hoony9845/msx-vdp-cartridge/hardware/fab/msx_v9990_cart_hole_check_print96.pdf

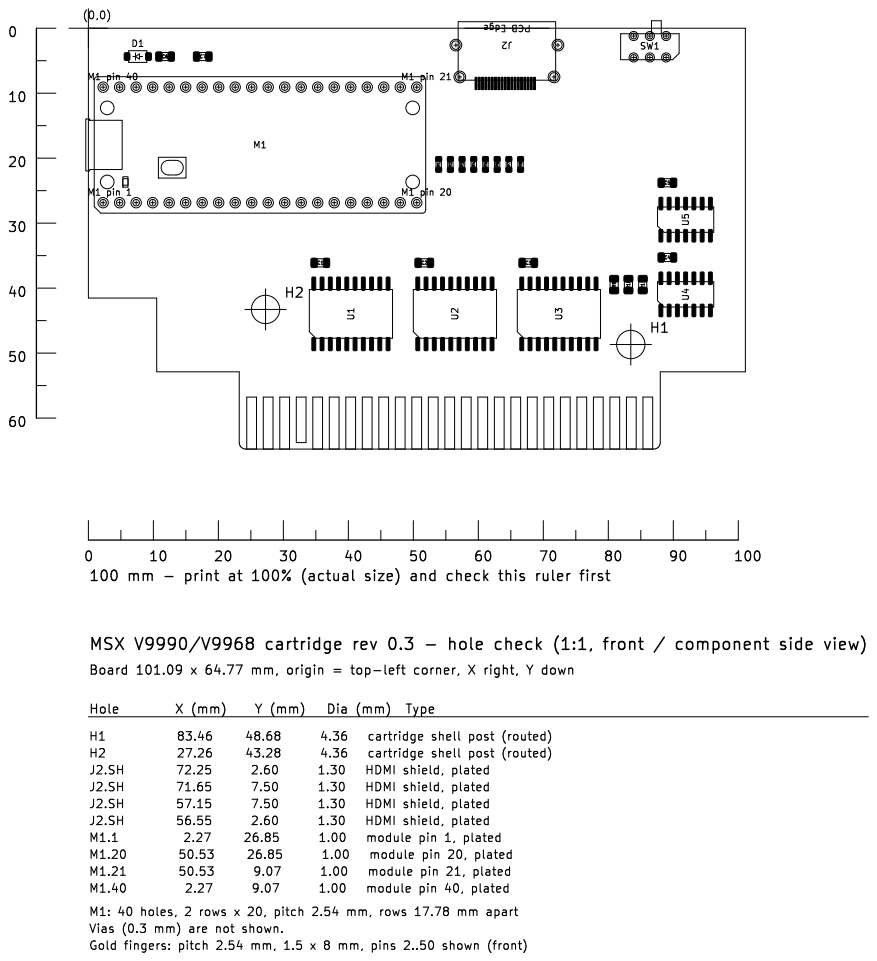
[picture p1: page 1]

Vias (0.3 mm) are not shown.
