hoony9845/msx-vdp-cartridge/hardware/fab_core2350b/msx_v9990_cart_core2350b_hole_check.pdf

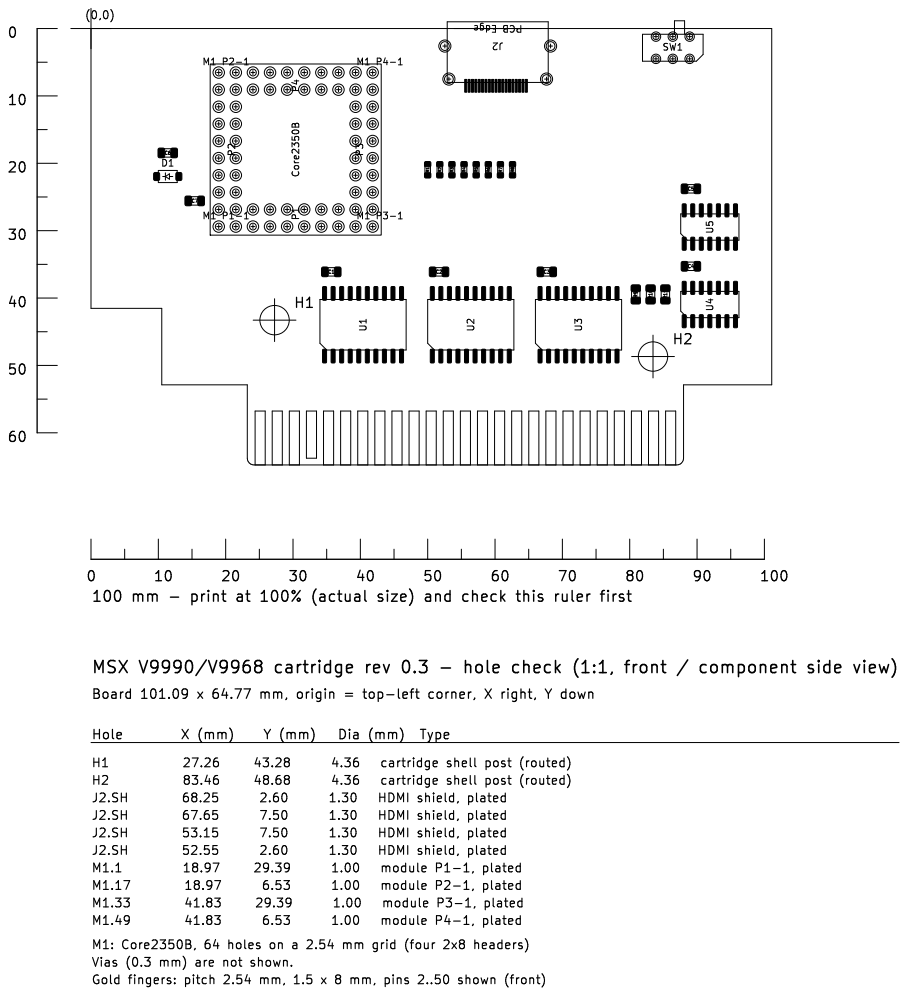
[picture p2: page 1]

Vias (0.3 mm) are not shown.
