hoony9845/msx-vdp-cartridge/hardware/fab_core2350b/msx_v9990_cart_core2350b_schematic.pdf

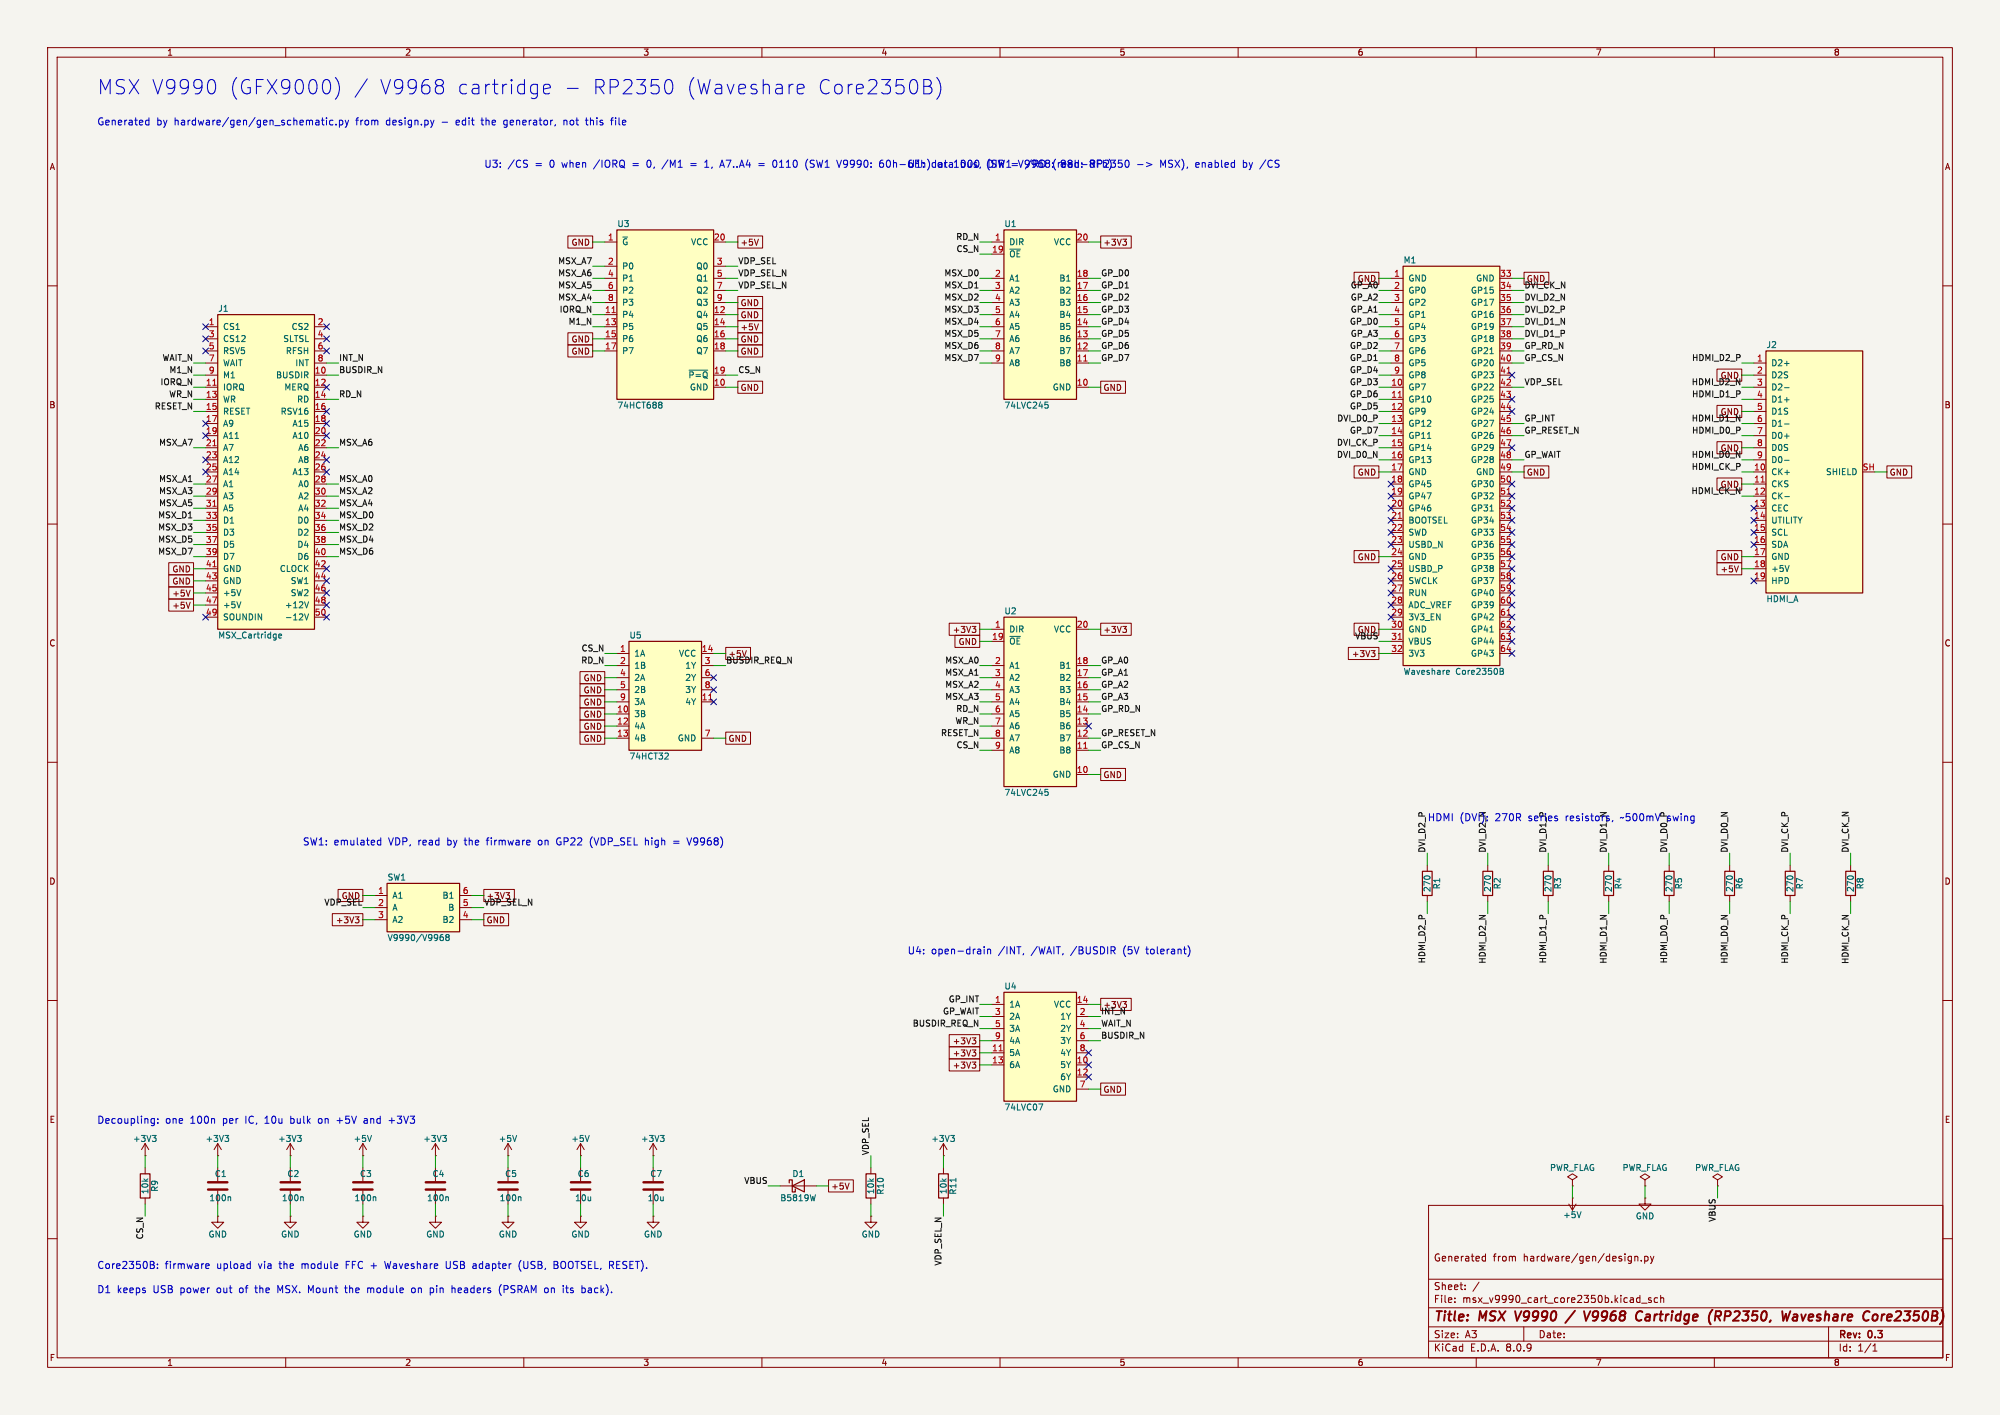
[picture p4: page 1]

GND 1 GP7 10 GP10 11 GP9 12 GP12 13 GP11 14 GP14 15 GP13 16 GND 17 GP45 18 GP47 19 GP0 2 GP46 20 BOOTSEL 21 SWD 22 USBD_N 23 GND 24 USBD_P 25 SWCLK 26 RUN 27 ADC_VREF 28
+3V3 GND GND GND GND
3V3_EN 29 GP2 3 GND 30 VBUS 31
