hoony9845/msx-vdp-cartridge/hardware/fab/msx_v9990_cart_hole_check.pdf

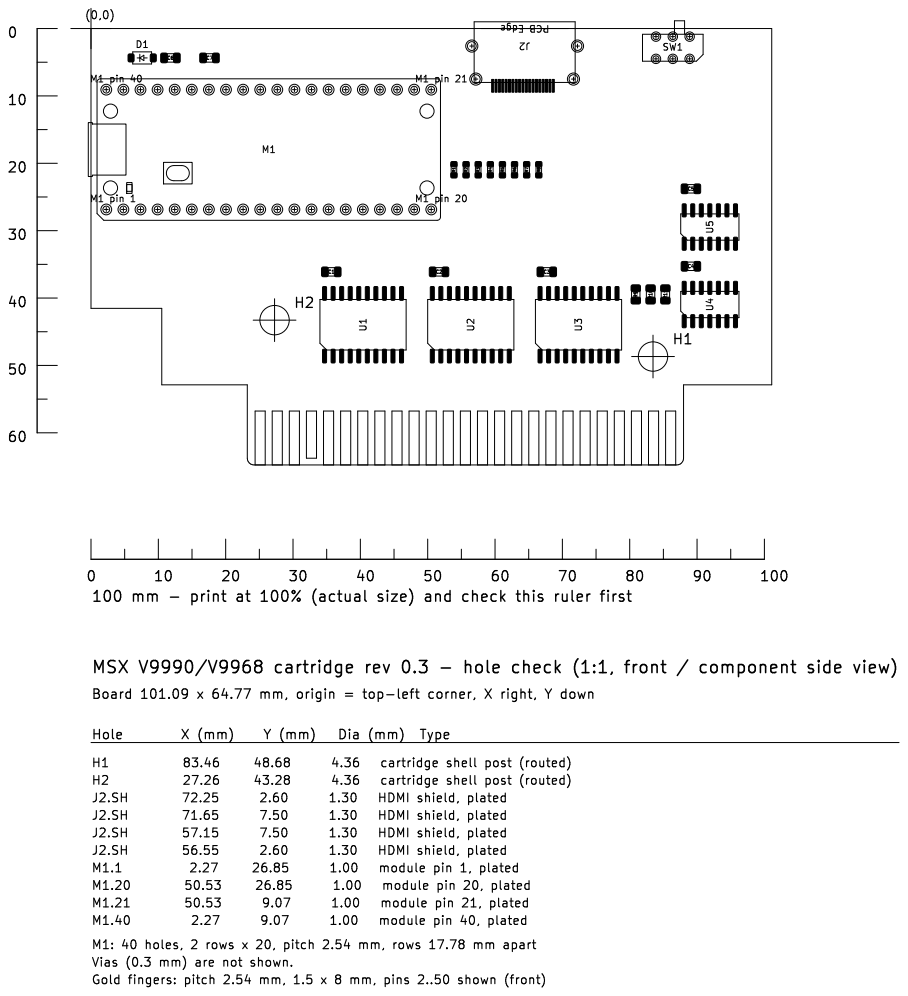
[picture p5: page 1]
