hoony9845/msx-vdp-cartridge/hardware/fab/msx_v9990_cart_schematic.pdf

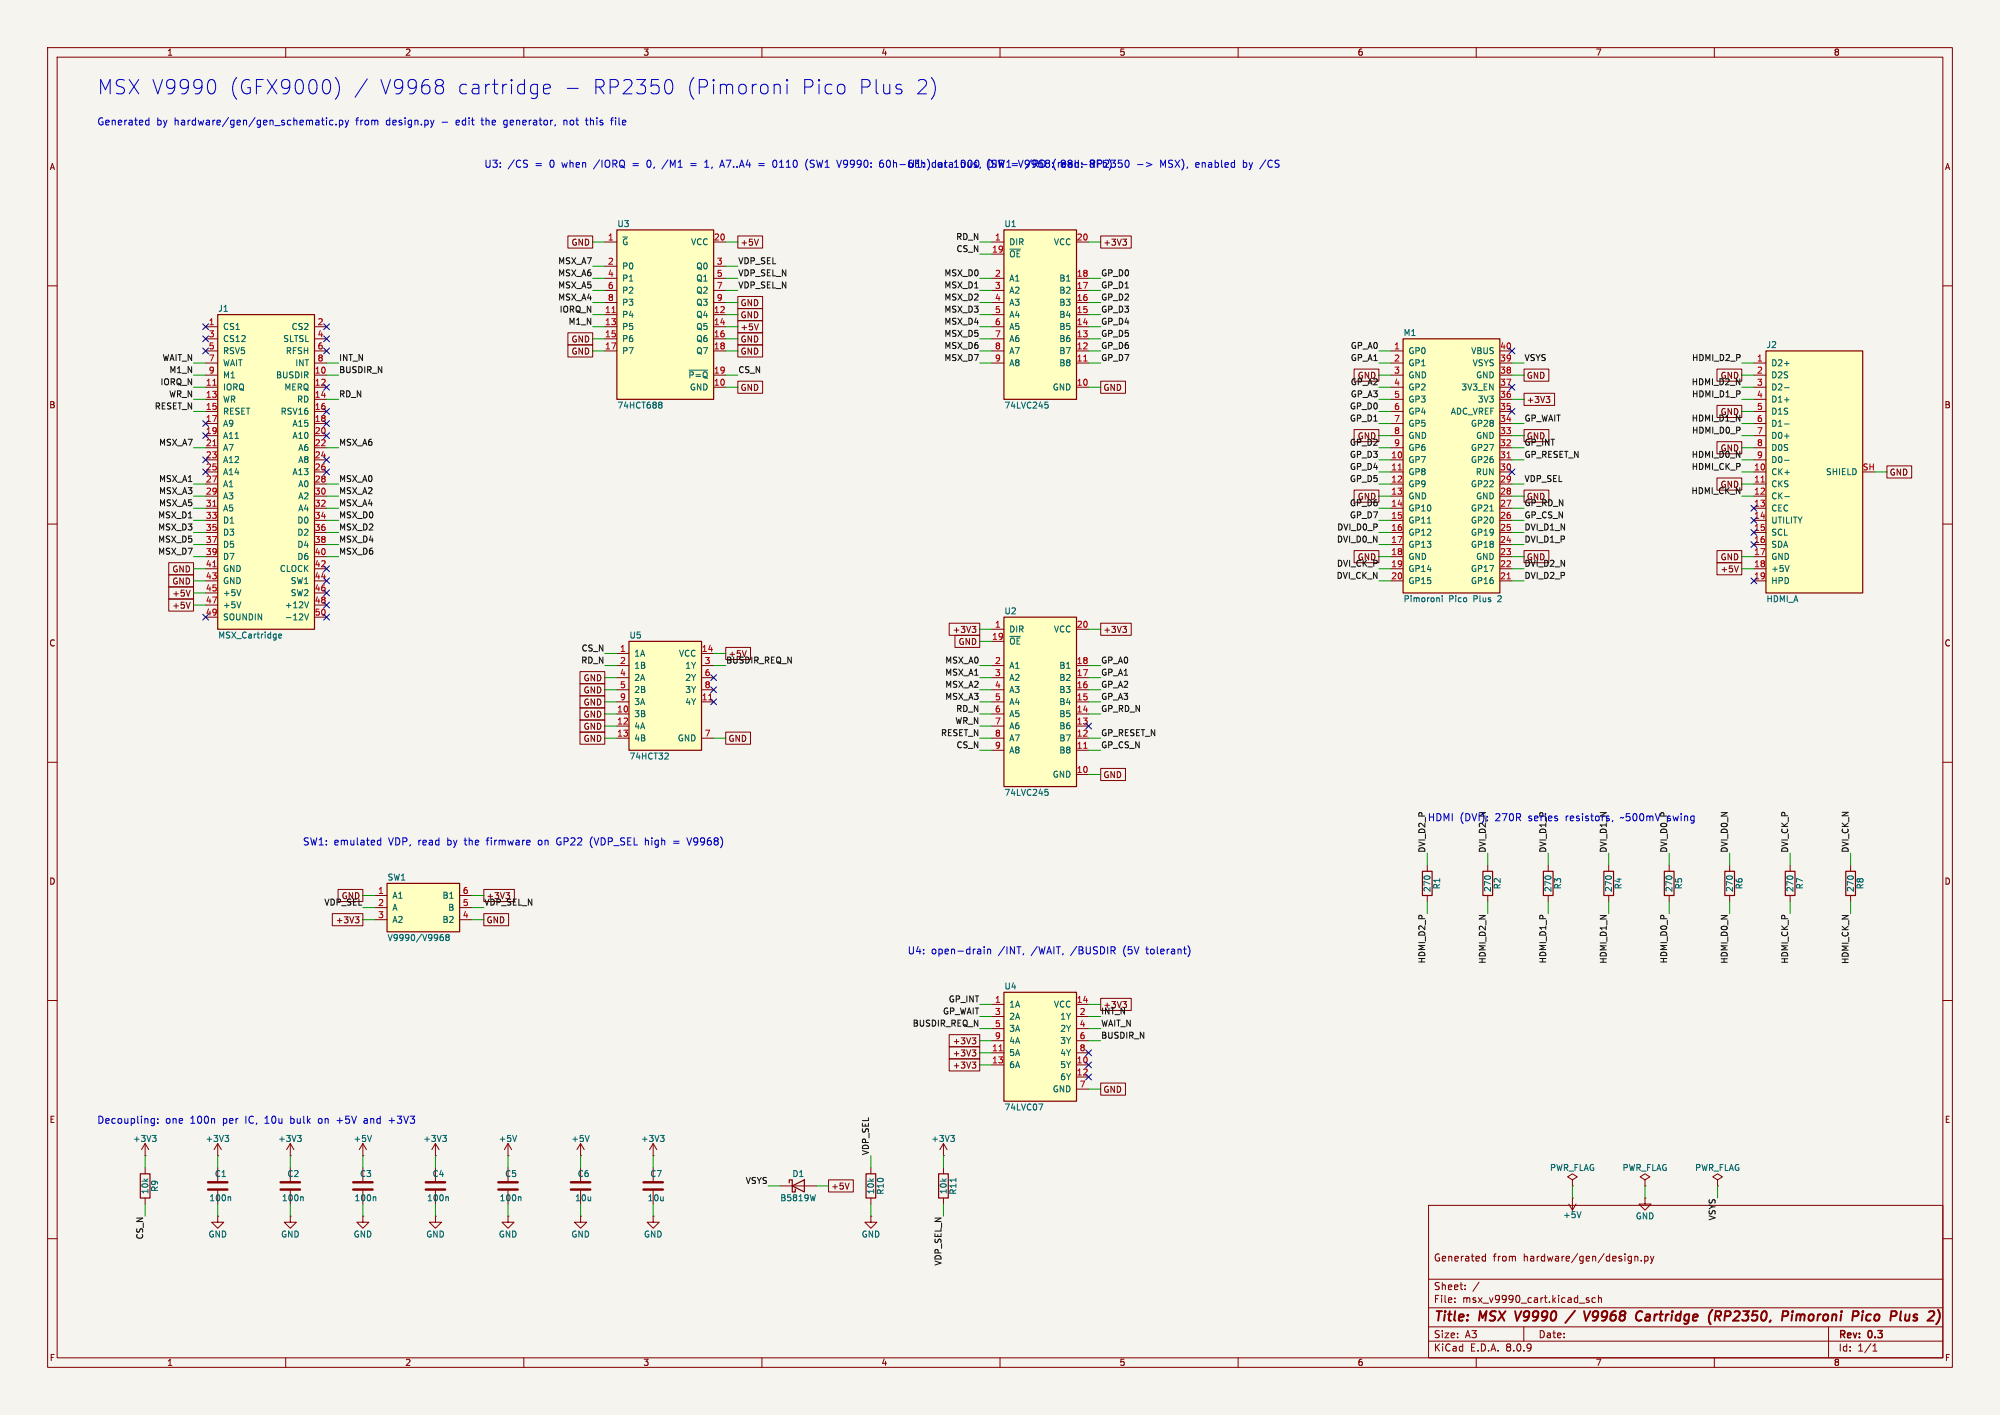
[picture p6: page 1]
