hoony9845/msx-vdp-cartridge/hardware/msx_v9990_cart/msx_v9990_cart.kicad_pcb

## KiCad design hardware/msx_v9990_cart/msx_v9990_cart.kicad_pcb (2026-10-25)

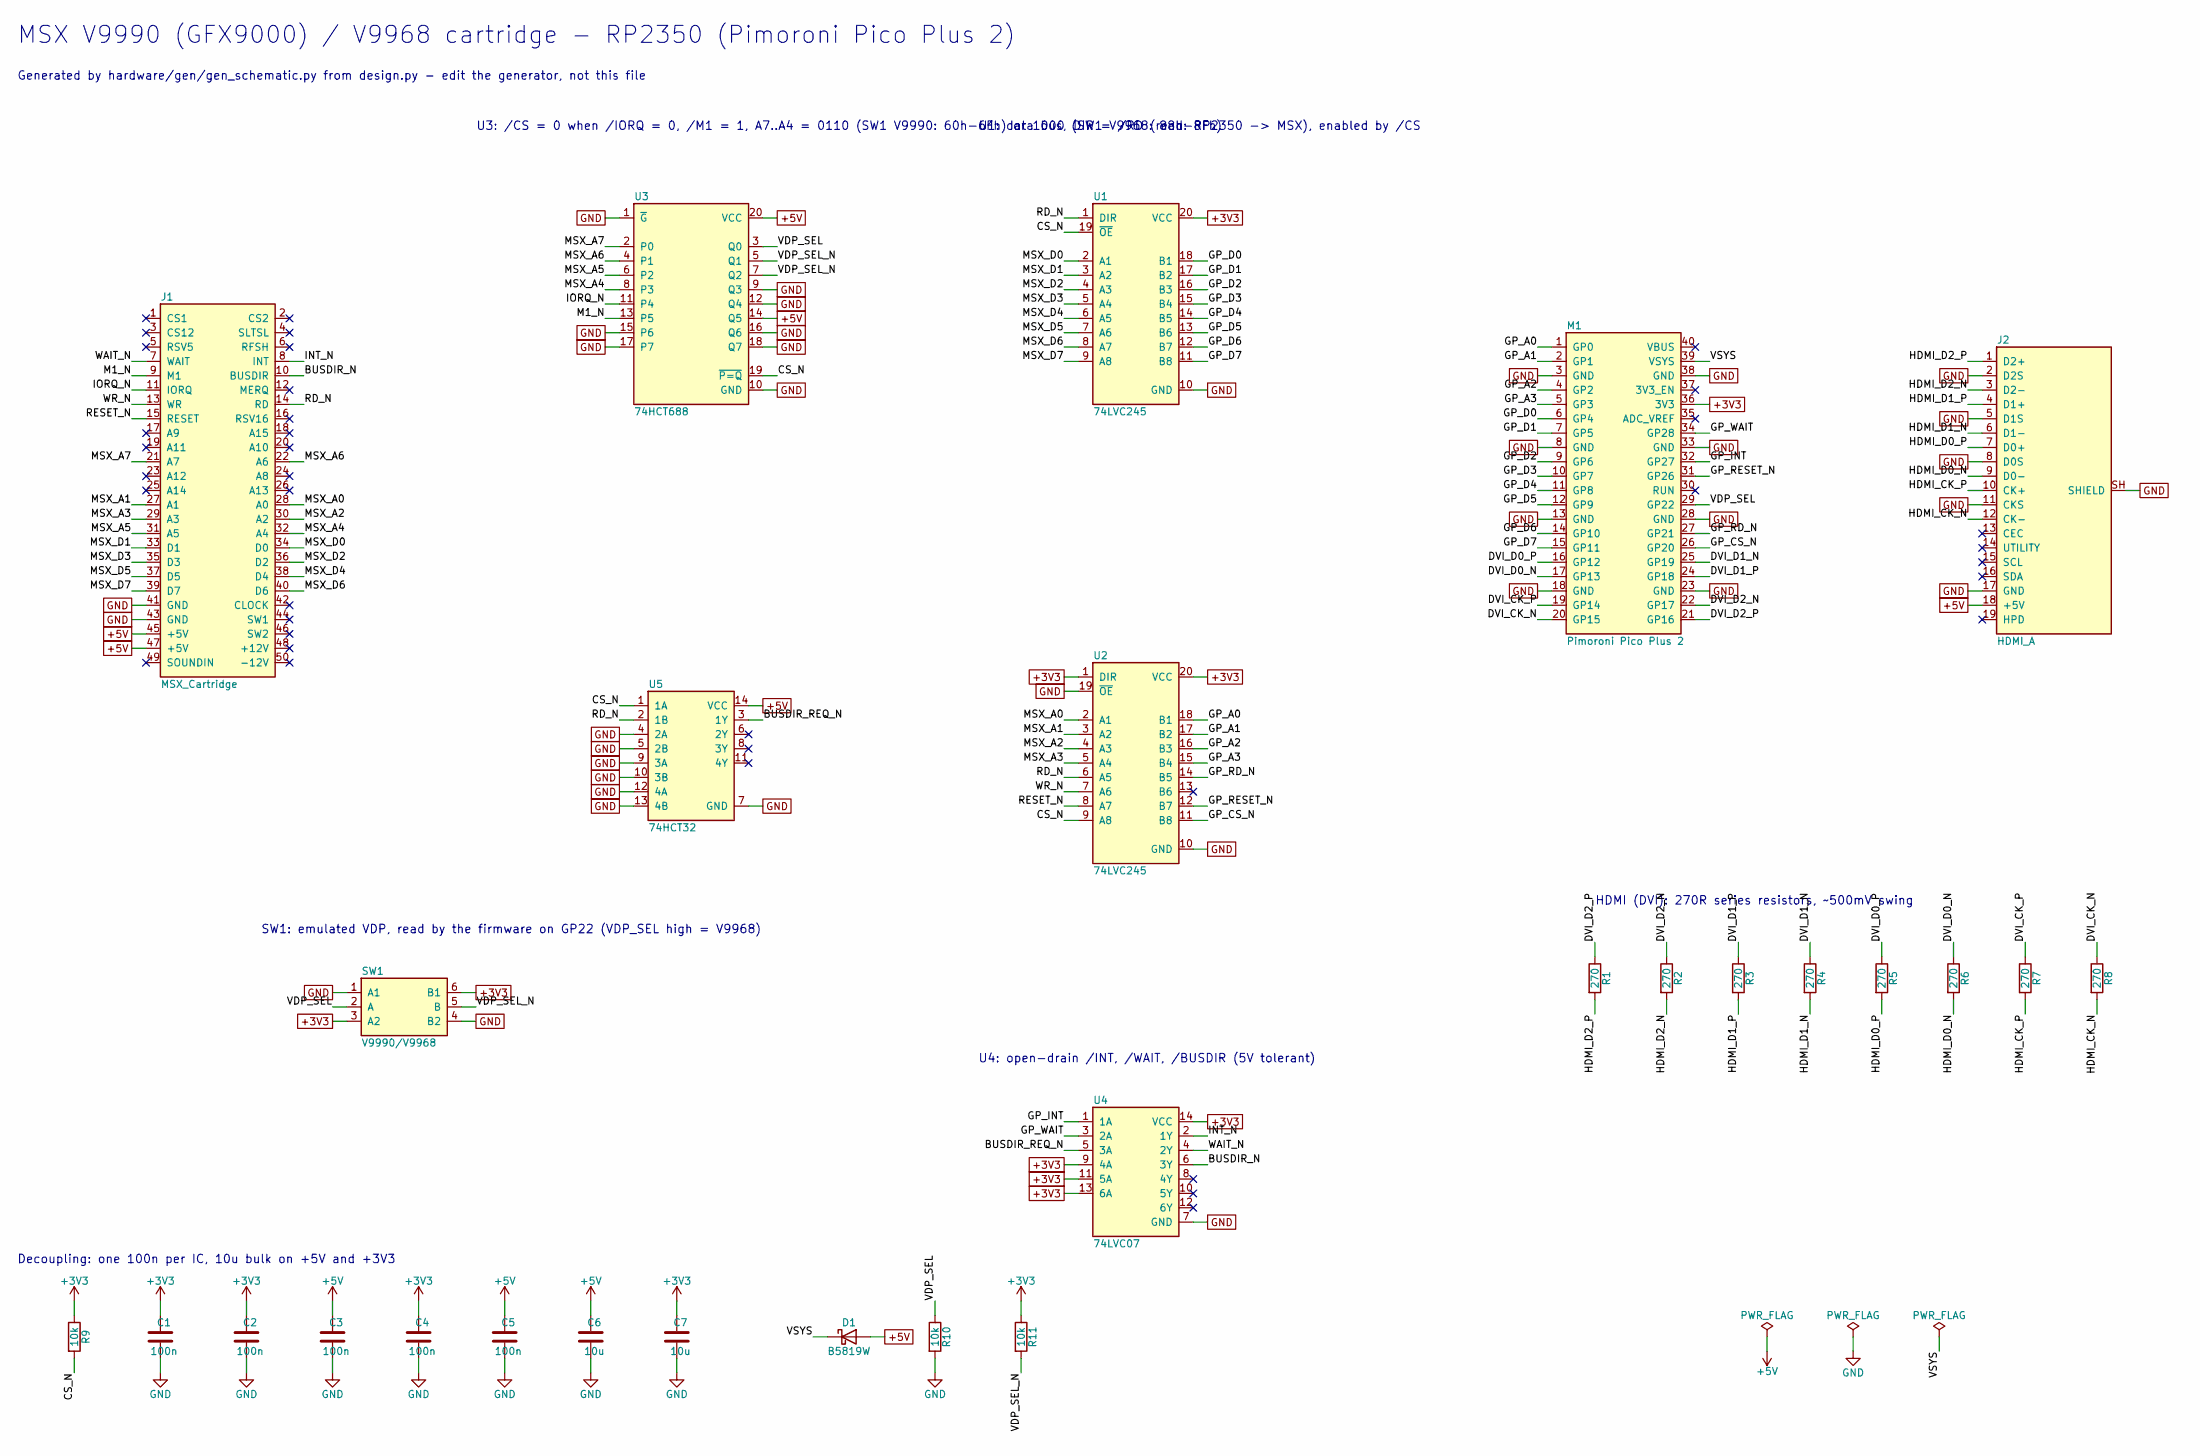
[picture p7: schematic msx_v9990_cart.kicad_sch, MSX V9990 / V9968 Cartridge (RP2350, Pimoroni Pico Plus 2)]

Parts:
C1, C2, C3, C4, C5: 100n; C_0805_2012Metric; MPN CL21B104KBCNNNC
C6, C7: 10u; C_0805_2012Metric; MPN CL21A106KAYNNNE
D1: B5819W; D_SOD-123; MPN B5819W
J1: MSX_Cartridge; MSX_Cartridge_Edge
J2: HDMI_A; HDMI_A_Amphenol_10029449-x01xLF_Horizontal; MPN 10029449-001RLF
M1: Pimoroni Pico Plus 2; RaspberryPi_Pico_Common_THT
R1, R2, R3, R4, R5, R6, R7, R8: 270; R_0603_1608Metric; MPN 0603WAF2700T5E
R9, R10, R11: 10k; R_0805_2012Metric; MPN 0805W8F1002T5E
SW1: V9990/V9968; SW_CK_JS202011AQN_DPDT_Angled; MPN JS202011AQN
U1, U2: 74LVC245; SOIC-20W_7.5x12.8mm_P1.27mm; MPN SN74LVC245ADWR
U3: 74HCT688; SOIC-20W_7.5x12.8mm_P1.27mm; MPN 74HCT688D
U4: 74LVC07; SOIC-14_3.9x8.7mm_P1.27mm; MPN SN74LVC07AD
U5: 74HCT32; SOIC-14_3.9x8.7mm_P1.27mm; MPN 74HCT32D

Connections:
+3V3: C1.1, C2.1, C4.1, C7.1, M1.36 (3V3), R9.1, R11.1, SW1.3 (A2), SW1.6 (B1), U1.20 (VCC), U2.1 (DIR), U2.20 (VCC), U4.9 (4A), U4.11 (5A), U4.13 (6A), U4.14 (VCC)
+5V: C3.1, C5.1, C6.1, D1.2 (A), J1.45 (+5V), J1.47 (+5V), J2.18 (+5V), U3.14 (Q5), U3.20 (VCC), U5.14 (VCC)
/BUSDIR_N: J1.10 (BUSDIR), U4.6 (3Y)
/BUSDIR_REQ_N: U4.5 (3A), U5.3 (1Y)
/CS_N: R9.2, U1.19 (~OE), U2.9 (A8), U3.19 (~P=Q), U5.1 (1A)
/DVI_CK_N: M1.20 (GP15), R8.1
/DVI_CK_P: M1.19 (GP14), R7.1
/DVI_D0_N: M1.17 (GP13), R6.1
/DVI_D0_P: M1.16 (GP12), R5.1
/DVI_D1_N: M1.25 (GP19), R4.1
/DVI_D1_P: M1.24 (GP18), R3.1
/DVI_D2_N: M1.22 (GP17), R2.1
/DVI_D2_P: M1.21 (GP16), R1.1
/GP_A0: M1.1 (GP0), U2.18 (B1)
/GP_A1: M1.2 (GP1), U2.17 (B2)
/GP_A2: M1.4 (GP2), U2.16 (B3)
/GP_A3: M1.5 (GP3), U2.15 (B4)
/GP_CS_N: M1.26 (GP20), U2.11 (B8)
/GP_D0: M1.6 (GP4), U1.18 (B1)
/GP_D1: M1.7 (GP5), U1.17 (B2)
/GP_D2: M1.9 (GP6), U1.16 (B3)
/GP_D3: M1.10 (GP7), U1.15 (B4)
/GP_D4: M1.11 (GP8), U1.14 (B5)
/GP_D5: M1.12 (GP9), U1.13 (B6)
/GP_D6: M1.14 (GP10), U1.12 (B7)
/GP_D7: M1.15 (GP11), U1.11 (B8)
/GP_INT: M1.32 (GP27), U4.1 (1A)
/GP_RD_N: M1.27 (GP21), U2.14 (B5)
/GP_RESET_N: M1.31 (GP26), U2.12 (B7)
/GP_WAIT: M1.34 (GP28), U4.3 (2A)
/HDMI_CK_N: J2.12 (CK-), R8.2
/HDMI_CK_P: J2.10 (CK+), R7.2
/HDMI_D0_N: J2.9 (D0-), R6.2
/HDMI_D0_P: J2.7 (D0+), R5.2
/HDMI_D1_N: J2.6 (D1-), R4.2
/HDMI_D1_P: J2.4 (D1+), R3.2
/HDMI_D2_N: J2.3 (D2-), R2.2
/HDMI_D2_P: J2.1 (D2+), R1.2
/INT_N: J1.8 (INT), U4.2 (1Y)
/IORQ_N: J1.11 (IORQ), U3.11 (P4)
/M1_N: J1.9 (M1), U3.13 (P5)
/MSX_A0: J1.28 (A0), U2.2 (A1)
/MSX_A1: J1.27 (A1), U2.3 (A2)
/MSX_A2: J1.30 (A2), U2.4 (A3)
/MSX_A3: J1.29 (A3), U2.5 (A4)
/MSX_A4: J1.32 (A4), U3.8 (P3)
/MSX_A5: J1.31 (A5), U3.6 (P2)
/MSX_A6: J1.22 (A6), U3.4 (P1)
/MSX_A7: J1.21 (A7), U3.2 (P0)
/MSX_D0: J1.34 (D0), U1.2 (A1)
/MSX_D1: J1.33 (D1), U1.3 (A2)
/MSX_D2: J1.36 (D2), U1.4 (A3)
/MSX_D3: J1.35 (D3), U1.5 (A4)
/MSX_D4: J1.38 (D4), U1.6 (A5)
/MSX_D5: J1.37 (D5), U1.7 (A6)
/MSX_D6: J1.40 (D6), U1.8 (A7)
/MSX_D7: J1.39 (D7), U1.9 (A8)
/RD_N: J1.14 (RD), U1.1 (DIR), U2.6 (A5), U5.2 (1B)
/RESET_N: J1.15 (RESET), U2.8 (A7)
/VDP_SEL: M1.29 (GP22), R10.1, SW1.2 (A), U3.3 (Q0)
/VDP_SEL_N: R11.2, SW1.5 (B), U3.5 (Q1), U3.7 (Q2)
/VSYS: D1.1 (K), M1.39 (VSYS)
/WAIT_N: J1.7 (WAIT), U4.4 (2Y)
/WR_N: J1.13 (WR), U2.7 (A6)
GND: C1.2, C2.2, C3.2, C4.2, C5.2, C6.2, C7.2, J1.41 (GND), J1.43 (GND), J2.2 (D2S), J2.5 (D1S), J2.8 (D0S), J2.11 (CKS), J2.17 (GND), J2.SH (SHIELD), M1.3 (GND), M1.8 (GND), M1.13 (GND), M1.18 (GND), M1.23 (GND), M1.28 (GND), M1.33 (GND), M1.38 (GND), R10.2, SW1.1 (A1), SW1.4 (B2), U1.10 (GND), U2.10 (GND), U2.19 (~OE), U3.1 (~G), U3.9 (Q3), U3.10 (GND), U3.12 (Q4), U3.15 (P6), U3.16 (Q6), U3.17 (P7), U3.18 (Q7), U4.7 (GND), U5.4 (2A), U5.5 (2B), U5.7 (GND), U5.9 (3A), U5.10 (3B), U5.12 (4A), U5.13 (4B)

Notes on the sheet:
MSX V9990 (GFX9000) / V9968 cartridge - RP2350 (Pimoroni Pico Plus 2)
Generated by hardware/gen/gen_schematic.py from design.py - edit the generator, not this file
U3: /CS = 0 when /IORQ = 0, /M1 = 1, A7..A4 = 0110 (SW1 V9990: 60h-6Fh) or 1000 (SW1 V9968: 88h-8Fh)
SW1: emulated VDP, read by the firmware on GP22 (VDP_SEL high = V9968)
U1: data bus, DIR = /RD (read: RP2350 -> MSX), enabled by /CS
U4: open-drain /INT, /WAIT, /BUSDIR (5V tolerant)
HDMI (DVI): 270R series resistors, ~500mV swing
Decoupling: one 100n per IC, 10u bulk on +5V and +3V3

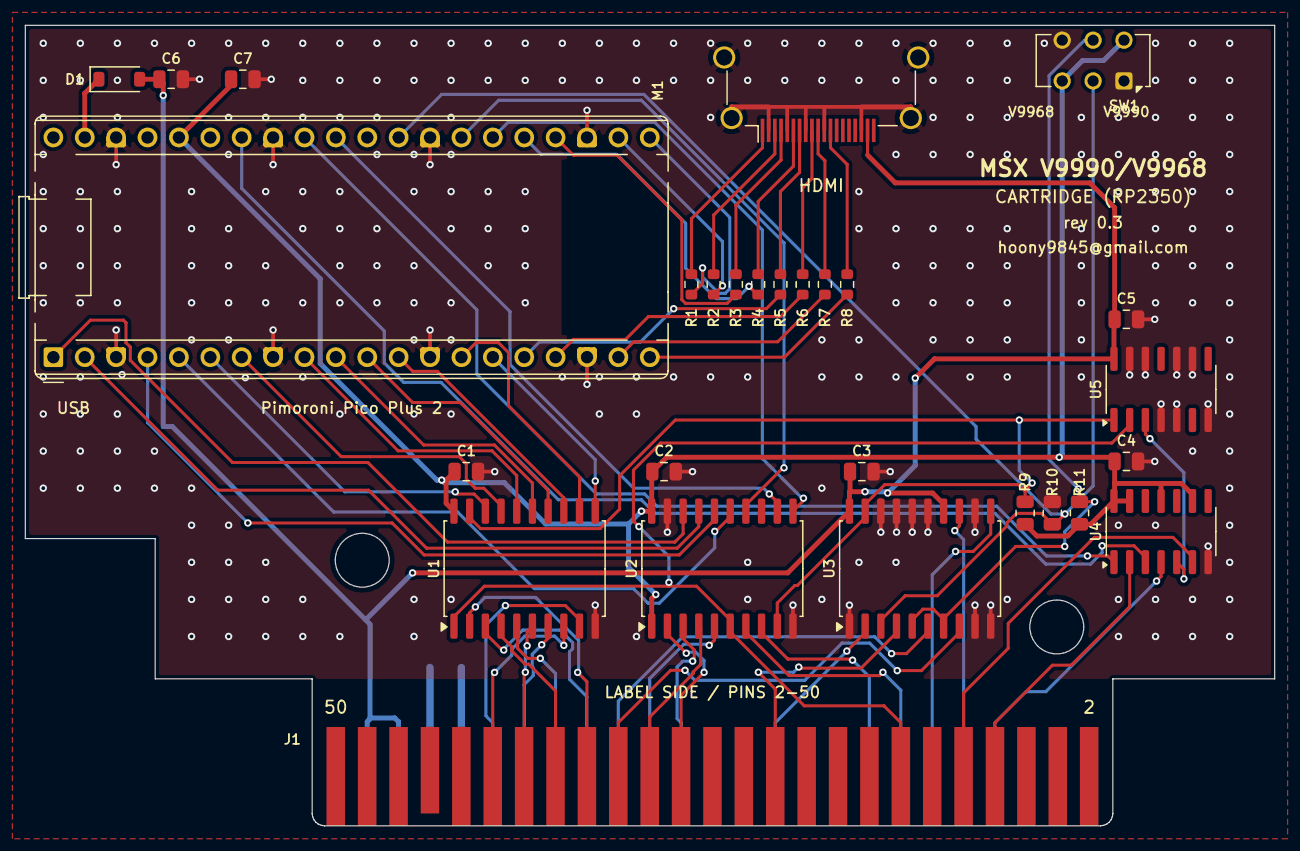
[picture p8: board msx_v9990_cart.kicad_pcb from above]

Board: 2 copper layers, 101.1 x 64.8 mm, 28 parts (0 on the bottom side), 65 nets.
