hoony9845/msx-vdp-cartridge/(commit log)

2026-10-21 Initial commit: RP2350-based V9990 (GFX9000 compatible) MSX cartridge
    - core/: portable V9990 core (ports, registers, palette, bitmap renderer,
    command engine STOP/LMMC/LMMV/PSET), shared by host and firmware
    - host/: PC unit tests and a render demo
    - firmware/: pico-sdk project for the Pimoroni Pico Plus 2 (PIO + DMA MSX
    bus interface, HSTX DVI 640x480 output, PSRAM VRAM, dual-core)
    - hardware/: generated KiCad 8 cartridge PCB (schematic, layout, Freerouting
    autoroute, GND pours) with JLCPCB Gerbers, BOM, CPL and a 1:1 hole check PDF
    - docs/: wiring and pin assignment
    [msx_v9990_cart-B_Cu.gbl, msx_v9990_cart-B_Mask.gbs, msx_v9990_cart-B_Paste.gbp, msx_v9990_cart-B_Silkscreen.gbo, msx_v9990_cart-Edge_Cuts.gm1, msx_v9990_cart-F_Cu.gtl, msx_v9990_cart-F_Mask.gts, msx_v9990_cart-F_Paste.gtp]
2026-10-21 Add Waveshare Core2350B cartridge variant; silkscreen fixes
    Hardware
    - Generators take MSX_VARIANT=picoplus2|core2350b; the Core2350B board
    (msx_v9990_cart_core2350b/, fab_core2350b/) shares outline, edge
    connector, bus logic and HDMI with the Pico Plus 2 board
    - Core2350B: generated 64-pin footprint (four 2x8 headers, pin map from the
    Waveshare schematic), module on pin headers (PSRAM on its back), MSX +5V
    via D1 into VBUS; USB/BOOTSEL/RESET come from the Waveshare FFC adapter
    - Fixed 0.3mm escapes for the inner-ring 3V3/GND pins, GND fan-out rules
    for the module, variant-aware BOM and hole-check PDF
    - Both boards: shortened tongue (fingers to the edge), moved H1/H2, email
    on th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
    [msx_v9990_cart-B_Cu.gbl, msx_v9990_cart-B_Mask.gbs, msx_v9990_cart-B_Paste.gbp, msx_v9990_cart-B_Silkscreen.gbo, msx_v9990_cart-Edge_Cuts.gm1, msx_v9990_cart-F_Cu.gtl, msx_v9990_cart-F_Mask.gts, msx_v9990_cart-F_Paste.gtp]
2026-10-23 Core: P1/P2 pattern modes, sprites, LMMM, mode decoding per manual
    - P1: two layers with per-layer palettes, front/back split (R#27), scroll
    - P2: 1024x512 image plane, even/odd PGT byte palettes
    - P1/P2 sprites: 125 entries, 16 per line (hidden ones count), front/back
    priority, lower number wins, X wrap above 1008, SPD disable
    - Vertical scroll split (writing SCAY/SCBY low restarts the layer at the
    current line), per-frame latch of the high bytes, R512/R256 roll
    - Display mode decoding from the manual's table (B2/B4 via MCS, B5/B6 via
    HSCN/C25M); interlace height only with IL+EO
    - VRAM pointers update on R#2/R#5 only; register write masks
    - LMMM (bitmap coordinates) in the command eng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
2026-10-23 Add openMSX comparison harness and trace recorder
    - host/replay: replays a V9990 port trace through the core, writes shots
    - tools/compare: scenario generator, headless openMSX 16.0 runner (GFX9000),
    dot-accurate comparison (calibration shots locate the display area and
    every dot column), report with side-by-side diff images
    - record.tcl/record.sh: record real software's V9990 port accesses
    (watchpoints) plus periodic screenshots; compare_trace.sh replays and
    compares; selftest_record runs a Z80 program end to end
    - All scenarios (P1 layers/scroll, P2, sprites, BD16, BP4 B3, LMMV, LMMM)
    match openMSX 16.0 exactly
2026-10-23 CMMC/CMMM, positional FC/BC colours; Chase H.Q. regression test
    Core
    - CMMC and CMMM (1 bit per dot, MSB first, continuous across rows;
    FC for 1, BC for 0)
    - FC/BC/WM follow VRAM bit positions (bits 0-7 = VRAM0/even byte,
    8-15 = VRAM1/odd byte, 2/4bpp use the dot's bits) for LMMV, PSET, CMMx
    - Resolved the remaining VERIFY notes against the manual (NX/NY = 0,
    LMMC data order, write mask lanes, P2 VRAM layout)
    Compare tools
    - record.tcl keeps only the low byte of 16-bit I/O addresses (OUT (C),A)
    - shot_window.py + compare.py --window: best of -4..+2 frames around each
    recorded shot, tearing detection (every line matches some frame)
    - compare_trace.sh: V9990_SKIP_BEFORE skips power-on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
    [v9990.h, v9990_cmd.c, v9990_regs.h]
2026-10-23 Verify Another World (turbo R) and VRAM-level comparison
    - Another World (Edd Biddulph, turbo R + V9990 + OPL4): 113/113 shots of
    the 4-minute intro match openMSX 16.0 (B2 384x240 BP4, LMMV XOR polygons)
    - setup_machines.sh / make_cbios_turbor.py: C-BIOS based turbo R test
    machine (version byte 3, CHGCPU/GETCPU via S1990, R800, E6 timer, PCM)
    and a MoonSound without the Yamaha wave ROM - no system ROMs needed
    - B2 calibration (384x240, MCS) and per-line vertical calibration:
    openMSX hides the first line of the 240-line modes
    - VRAM dumps at every shot (record.tcl V9990_DUMP_VRAM, replay
    REPLAY_DUMP_VRAM) and compare_vram.py: Chase H.Q. VRAM equals openMSX at
    69 of 73 shots includ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
2026-10-25 Add V9968 + geo3d v2.0 emulation, selectable in firmware
    - core/v9968*.c: V9968 (V9958 superset): ports, registers, Port#4
    interrupts/lock, 256KB VRAM, all screen modes incl. YJK/YAE and EPAL,
    sprite modes 1-3 (SP3 scaling, reversal, palette sets, transparency),
    every command incl. LRMM/LFMC/LFMM, following HRA!'s RTL
    - core/geo3d.c: geo3d v2.0, a port of the bit-exact Python reference
    model; commands are fed to the V9968 command engine when CE = 0
    - firmware: chip chosen at boot (CMake MSX_VDP_DEFAULT, USB serial
    'chip v9990|v9968' saved in flash); V9968 at nibble 8-F of the decoded
    ports, VRAM in SRAM, just-in-time line rendering for raster effects
    - verification: geo3d logs id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
    [bus.c, bus.h, dvi_out.c, dvi_out.h, gen_cmds.py, geo3d.c, geo3d.h]
2026-10-25 PCB rev 0.2: SW1 selects the V9990 or the V9968 cartridge
    - SW1 (C&K JS202011AQN, DPDT, right angle, top edge): sets the 74HCT688
    compare value A7-A4 to 0110 (V9990, 60h-6Fh) or 1000 (V9968 + geo3d,
    88h-8Fh) and drives GP22 (VDP_SEL); R10/R11 hold the inputs while the
    slider moves
    - GP22 reads SW1 instead of /WR (U2 still buffers /WR, output open)
    - firmware: the chip follows SW1 at boot (MSX_VDP_SWITCH, default ON);
    rev 0.1 boards build with -DMSX_VDP_SWITCH=OFF (flash / USB serial)
    - both variants regenerated: ERC 0, DRC 0, 0 unconnected
    [msx_v9990_cart-B_Cu.gbl, msx_v9990_cart-B_Mask.gbs, msx_v9990_cart-B_Paste.gbp, msx_v9990_cart-B_Silkscreen.gbo, msx_v9990_cart-Edge_Cuts.gm1, msx_v9990_cart-F_Cu.gtl, msx_v9990_cart-F_Mask.gts, msx_v9990_cart-F_Paste.gtp]
2026-10-25 V9968 renderer: YJK delay, YAE transparency, sprites ignore R#27
    - YJK/YAE: the picture and the sprites come out 4 dots late (J/K need a
    whole group), the first 4 dots show the border, as in openMSX
    - YAE: palette colour 0 is transparent (border unless TP)
    - sprites are not shifted by R#27 (vdp_sprite_makeup_pixel gets the
    unscrolled position); only hidden in the border R#27 opens
    - compare: YJK sprite colour scenes; trace2cmds.py and REPLAY_GEO3D_CMDS
    run a scenario's commands through HRA!'s RTL: LRMM, LFMM and the geo3d
    textured scene give the same 256KB of VRAM as the core, so their
    remaining differences to the openMSX fork are on the fork's side
    - rtl/bisect.py: first command w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
2026-10-25 V9968 LMCM: the end check before the first read; fix the RTL replay
    - LMCM ends without reading when it starts past the edge of its last line
    (vdp_command.v checks before the first read)
    - v9968_cmd_replay: a command waiting for CPU data takes the next
    command's R#44 at once, as the RTL running in parallel does (and the
    firmware, whose engine always runs); a stale TR no longer stops other
    commands. The open RTL differences (sets 2140, 2240, 2241, 2250, 2281)
    were these two replay artefacts and the LMCM check: all identical now
    [v9968_cmd.c]
2026-10-25 RTL comparison: 44/44 random sets identical; rename the bisect tool
    rtl/bisect.py shadowed Python's bisect module (random imports it), so the
    generator next to it broke: renamed to rtl_bisect.py.
    [rtl_bisect.py]
2026-10-25 PCB rev 0.3: outline and shell-post holes for the Overrich case
    The board outline and the two cartridge-shell holes now follow MSXLegend's
    KC MSX FLASH V3 (made for the Overrich Konami-style case), aligned on the
    finger edge: 101.09 x 64.77 mm, 11.89 mm tab, 4.36 mm holes. Finger
    position and size are unchanged.
    - J2 and SW1 follow the top edge; SW1 moves 8 mm left (x 108.5).
    - U1-U3 move 2 mm up, making room for the finger traces under the longer tab.
    - Fixed +5V track between two Pico pins to D1/C6 (Pico Plus 2).
    - Core2350B routes with "-us hybrid -hr 3:1" first (no GND island).
    [msx_v9990_cart-B_Cu.gbl, msx_v9990_cart-B_Mask.gbs, msx_v9990_cart-B_Paste.gbp, msx_v9990_cart-B_Silkscreen.gbo, msx_v9990_cart-Edge_Cuts.gm1, msx_v9990_cart-F_Cu.gtl, msx_v9990_cart-F_Mask.gts, msx_v9990_cart-F_Paste.gtp]
2026-11-07 Firmware on a Core2350B: Chase H.Q. runs to the race
    First test on real hardware (Waveshare Core2350B on the rev 0.3 PCB in
    an MSX2+). Each fix below was found there with the new diagnostics.
    - PSRAM: psram_detect_and_init() was inlined into flash code and halted
    in QMI direct mode (XIP stalls): now __no_inline, command table in RAM
    (same for set_flash_divisor). PSRAM runs at 126MHz (clk_sys / 2, RX
    delay 3; 2-5 read correctly)
    - /INT and /WAIT are released first thing in main(): GP27/GP28 reset to
    pull-down, which asserted both through the 74LVC07 and froze the MSX
    whenever the V9990 did not start
    - HR (P#5 bit 5) toggles every other DVI line, also in the blank: Chase
    H.Q. wait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
    [bus.c, bus.h, dvi_out.c, dvi_out.h, main.c, psram.c, psram.h, vdp_select.c]
2026-11-07 V9990: LINE command and the two bitmap cursors
    Found by recording MSXdev/Mapax V9990 games in openMSX: Dreams Puzzle
    draws with LINE and MSX in a Row moves a bitmap cursor.
    - LINE as openMSX: NX dots on the major axis (ARG MAJ), NY the minor
    length, raw 12-bit counts, ends after NX + 1 dots or when X leaves the
    image; DY keeps the last position
    - cursors 0 and 1 (attributes 0x7FE00/0x7FE08, 32x32 patterns at
    0x7FF00/0x7FF80) in all bitmap modes unless SPD: palette colour
    R#28 * 4 + CC, EOR complements (CC = 0 + EOR: the bitmap itself),
    shown 1 line (2 interlaced) below Y, cursor 0 in front
    Dreams Puzzle: the VRAM differences left are areas of commands started
    in the frame before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
2026-11-07 V9990 P1/P2 on the RP2350 in time: VRAM0 in SRAM, fused renderer
    Petscii Robots (P1, sprites) took 139 us per line on the Core2350B
    against a 63 us budget: the picture was stretched and streaked. The new
    "bench" serial command showed it was neither PSRAM nor flash code but
    plain CPU work; it now takes 56 us (60 us average in the game, clean).
    - VRAM is two banks in the core (v9990_init_banks, v9990_vram_ptr): the
    firmware keeps VRAM0 in the 256KB SRAM buffer the V9968 uses and VRAM1
    in PSRAM, halving PSRAM traffic (P1 layer A, sprites, even bitmap
    bytes); the renderer's row fetch copies VRAM0 and streams VRAM1
    - P1/P2 render straight to RGB565: per-layer 16-colour tables, the back
    l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
2026-11-08 V9968 renderer in time on the RP2350: G4 + sprite mode 3 fast path
    CAPE CIRCUIT (GRAPHIC4, sprite mode 3, EPAL) took 75 us a line on the
    Core2350B against the 31.7 us of the just-in-time V9968 output, so the
    bottom of the picture was cut off. Now 23 us average, 38 us max, no late
    lines.
    - 256-dot modes without YJK: palette (and GRAPHIC7 colours) converted to
    RGB565 once, cached on a palette generation counter (pal_gen, bumped by
    palette writes and kept across reset); one 32-bit word per dot (the dot
    doubled) written straight into the DVI line buffer
    - GRAPHIC4 decoded from the whole VRAM row, fused with the colour lookup;
    GRAPHIC7 rows read from the bank pointers
    - sprite mode 3: at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
    [bus.c, main.c, v9968.c, v9968.h, v9968_render.c]
2026-11-09 V9968 on the Core2350B: 384MHz, render two lines ahead, chunked commands
    Sprite mode 3 demos (LUMEN FORGE, MIST VALE, SUPER CAT) overran the 31.7 us
    just-in-time line on the hardware and showed torn lines.
    Renderer (output byte-identical, 3674/3674 shots of the 18 demo recordings):
    - translucent sprite dots mixed with the three channels in one word
    - mode 3 X scaling from per-width runs of each source dot (div_start, built
    once from the RTL coefficients), transparent runs skipped; Y from tables
    - GRAPHIC7 fused into the 32-bit output like GRAPHIC4
    - PROF sub-timers for sprite selection and drawing
    Firmware:
    - clk_sys 384MHz from pll_usb (VREG 1.30V, flash /5, bus.pio delays
    scaled), cl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
    [bus.c, main.c, v9968_render.c, vdp_select.c]
2026-11-10 Licences: MIT software, CERN-OHL-P v2 hardware, third-party notices
    - LICENSE (MIT) for the software, hardware/LICENSE (CERN-OHL-P v2) for
    the board design
    - THIRD_PARTY_NOTICES.md: HRA!'s V9968 RTL notice (Japanese formal text
    and English translation), Alex Moncks' geo3d model (MIT), pico-examples
    (BSD-3-Clause), behaviour references (openMSX, Yamaha manual)
    - the V9968 core follows HRA!'s RTL closely, so it keeps that RTL's
    conditions (non-commercial without permission); noted in its file
    headers and the README
    - notice lines in core/geo3d.h and firmware/src/dvi_out.c
    - tools/compare/v9968/rtl/tb.vvp (iverilog output containing the RTL)
    ignored; run.sh rebuilds it from a separa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
2026-11-14 V9968 LRMM fast path; command engine stops on bus events
    LRMM pixels inside a row run in a counted loop specialised for G4, FG4
    and G7 (the modes the kanon-ai demos use); the row's last pixel still
    goes through step_one. host/test_v9968_lrmm checks it against the
    general code in random budgets (state, clocks and VRAM after every
    call), and the 21 recorded demo traces replay to identical pictures.
    core1 no longer calls the engine in 32-clock pieces: it hands over the
    whole credit and the engine returns within ~32 clocks once the bus
    event ring moves (v9968_cmd_watch). The read table is refreshed once
    after the engine runs, which is enough since reads wait on /WAIT.
    LINE's error term is now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
    [bus.c, main.c, v9968.h, v9968_cmd.c]
2026-11-14 V9968 LRMM: IMP copies without reading the destination
    The kanon-ai demos' LRMMs all use LOP = IMP, so the specialised copies
    (G4, FG4, G7) now assume it and the rest go through the general row
    loop. With IMP the destination is not read, and the two pixels of a
    byte are written at once: G4 nibbles, and FG4 in an 8-bit mode, where
    both pixels write the whole byte and only the second one stays. The
    window is tested with two unsigned compares (an empty window leaves
    LRMM to step_one), and the bus watch values stay in registers.
    host/test_v9968_lrmm now draws IMP half the time; the 21 demo traces
    still replay to identical pictures. Core2350B, SUPER CAT running, G4:
    172 ns per pixel as core1 run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
2026-11-14 V9968 sprite mode 3: compose while drawing, mix cache
    The sprite dot arrays (on, colour, transparency) are one 16-bit word
    per dot. In the 256-dot fast path a mode 3 sprite now composes its
    dots into the output as it takes them (the first sprite to take a dot
    keeps it, so the result is final) instead of a second pass over the
    line; only non-transparent source dots are visited (a nibble mask), and
    collisions are looked for only until the first one sets C. Translucent
    results come from a 4096-entry cache keyed by background index, sprite
    colour and transparency, emptied when the palette (pal_gen), gamma,
    mode or border changes.
    Checked against the previous renderer: the 21 demo traces give th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
    [main.c, v9968_render.c]
2026-11-14 V9968 HMMM/LMMM fast path
    MIST VALE redraws its G7 double buffer with LMMM and HMMM every frame
    (about 10k LMMM pixels and 17k HMMM bytes); the general per-pixel code
    took ~38 ms a frame, longer than the demo's frame, so half-drawn pages
    showed (flicker). HMMM and LMMM now get a row fast path like LRMM's:
    specialised G4 and G7 copies, a general row loop for the other modes,
    and the same stop on bus events. The last pixel of a row and the screen
    edge are left to step_one.
    host/test_v9968_lrmm becomes test_v9968_cmdfast and checks LRMM, HMMM
    and LMMM in lockstep against the general code (15000 random commands
    identical, four planted mutations caught); the 21 demo traces replay to
    identical pi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
2026-11-14 V9968: a status read clears only the flags the CPU saw
    The CPU gets a status byte from core1's read table, but the read then
    cleared the live flags. When the video side set F between the table
    refresh and the read, the CPU saw F = 0 and F was cleared anyway: the
    frame interrupt was lost. MIST VALE resets its water raster scroll
    (R#27) in that interrupt, so the next frame was drawn shifted 1-4 dots
    (the whole picture jumped sideways now and then), and the page flip of
    that frame was skipped.
    v9968_read_port_seen() takes the value the CPU was answered with and
    clears only F, FH, 5S and C bits set in it; bus.c passes the read table
    entry (only core1 writes it, and the read SM takes it after co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
    [bus.c, v9968.c, v9968.h]
2026-11-14 V9968: geo3d's state outside v9968_t
    geo3d_t (~45KB of model RAMs) was part of v9968_t, so the firmware's
    bench copy of the VDP state took 52KB of SRAM, all of it copied on each
    "bench". v9968_t now points to the caller's geo3d_t (v9968_init takes
    it; v9968_reset keeps it). The bench copy is 0.7KB; as it shares geo3d
    with the running VDP, the LRMM bench steps the engine itself
    (v9968_cmd_step, not v9968_service) and no longer clears geo3d's
    running flag. (copy_to_ram puts every function in SRAM as well, so the
    command engine's fast paths need the room.)
    [bus.c, main.c, v9968.c, v9968.h]
2026-11-14 geo3d: faster command generation
    On the Core2350B geo3d_next_command took ~1500 CPU cycles a command in
    NIGHT-RAVEN GEO3D (filled faces), more than the ~520-cycle time the
    cartridge needs to draw the average command:
    - floor_div divides in 32 bits when both operands fit (hardware SDIV;
    64-bit division is a library call), with the same floor rounding;
    - untextured face rows go through flat_span: the face's corners are
    taken once by face_rows, and only the x crossings are computed (the
    same arithmetic as face_span, without u/v);
    - a wireframe RUN keeps the edges it clips (the RTL lets the Z80 not
    write the model while busy), instead of clipping each again when its
    LINE is issued.
    150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
    [geo3d.c, geo3d.h]
2026-11-14 V9968 LINE fast path; geo3d's commands back to back
    In NIGHT-RAVEN GEO3D (filled faces drawn as horizontal LINEs, ~16
    pixels each) the command engine took 20 times the cartridge's time
    while geo3d ran: LINE went through the general per-pixel code (~1.2 us
    a pixel, the chip ~81 ns), and every command cost a core1 loop pass.
    - LINE pixels before the last one and away from the screen edges skip
    conditions()/advance(): the error term, DX/DY on the axes, NX and SX
    stepping by one, as the RTL;
    - a horizontal LINE (NY = 0, X major) with IMP, or a T-op on a colour
    other than 0, in a 256-pixel mode is a fill (memset);
    - the last pixel ends the command there as step_one does (SX back to
    R#32,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
    [v9968_cmd.c]
2026-11-14 geo3d: textured face rows in 32 bits
    SKYBOUND and LUNAR COMMUTE fill textured faces with LRMM rows, and
    face_span's textured path (64-bit values throughout) took ~1100-1600 CPU
    cycles a command on the Core2350B. face_rows now also takes the face's
    texture coordinates and whether it is textured, and tex_span computes
    the row from them: the same candidates in the same order (the first of
    equal x wins on each side), in 32 bits where the values fit (x, u, v)
    and 64 for the products and the step terms. The old 64-bit path is
    gone; face_span picks tex_span or flat_span.
    9.6 million random face rows (horizontal edges, equal x, coordinates
    out to 16 bits, untextured faces mixed in) match the previo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
2026-11-14 V9968 LRMM: geo3d's registers in one go, the row's last pixel
    - v9968_service writes geo3d's LRMM (R#32-R#45, R#47-R#50, R#46) in one
    go, as it does a LINE; R#34 clears SY's fraction as the register write
    does. 2 million random states give the same VDP state as writing the
    registers one at a time.
    - lrmm_run ends a row (NX = R#40) itself instead of step_one: the source
    or the colour outside the window, put_pixel, the row start stepped,
    DX back to R#36, DY/NY on, NX = 1, finish after the last row or at the
    bottom edge. Pixels at the screen edge still go to step_one.
    test_v9968_cmdfast stays identical call by call; six mutations of the
    new code are caught.
    Core2350B, SKYBOUND (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
